Jaycar-Electronics/Game-Machine/images/NPI00011a.jpg

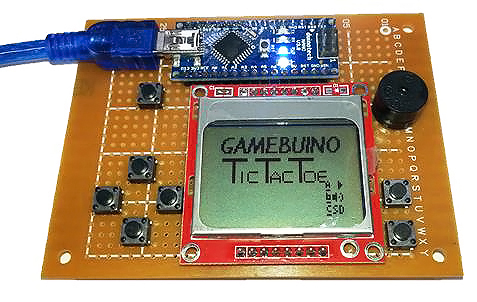
images/NPI00011a.jpg
