Jaycar-Electronics/Game-Machine/(threads)

Thread 1 (2021-09-18):

Photo doesn't match the wiring diagram

Littlejonnie, 2021-09-18:
I've wired it up as per the photos/video but it doesnt turn on. I checked the wiring diagram and it doesnt match the photos.
Eg
Instructions list
D13 | Screen SCLK via divider | Orange

But wiring diagram shows SCLK attached to AO on the board.

Which one is correct?
